ichiken-youtube/312_FlybackUSBCharger/README.md

# FlybackUSBCharger
本リポジトリはイチケンが以下の動画で製作した自作フライバックコンバータ回路のリポジトリです。  
イチケン USB充電器を自作する。「勢いで作るフライバックコンバーター」編 (https://www.youtube.com/watch?v=C0eDFmK-wXY)
