ichiken-youtube/312_FlybackUSBCharger/FlybackConverter.kicad_pcb

## KiCad design FlybackConverter.kicad_pcb (2024-11-19)

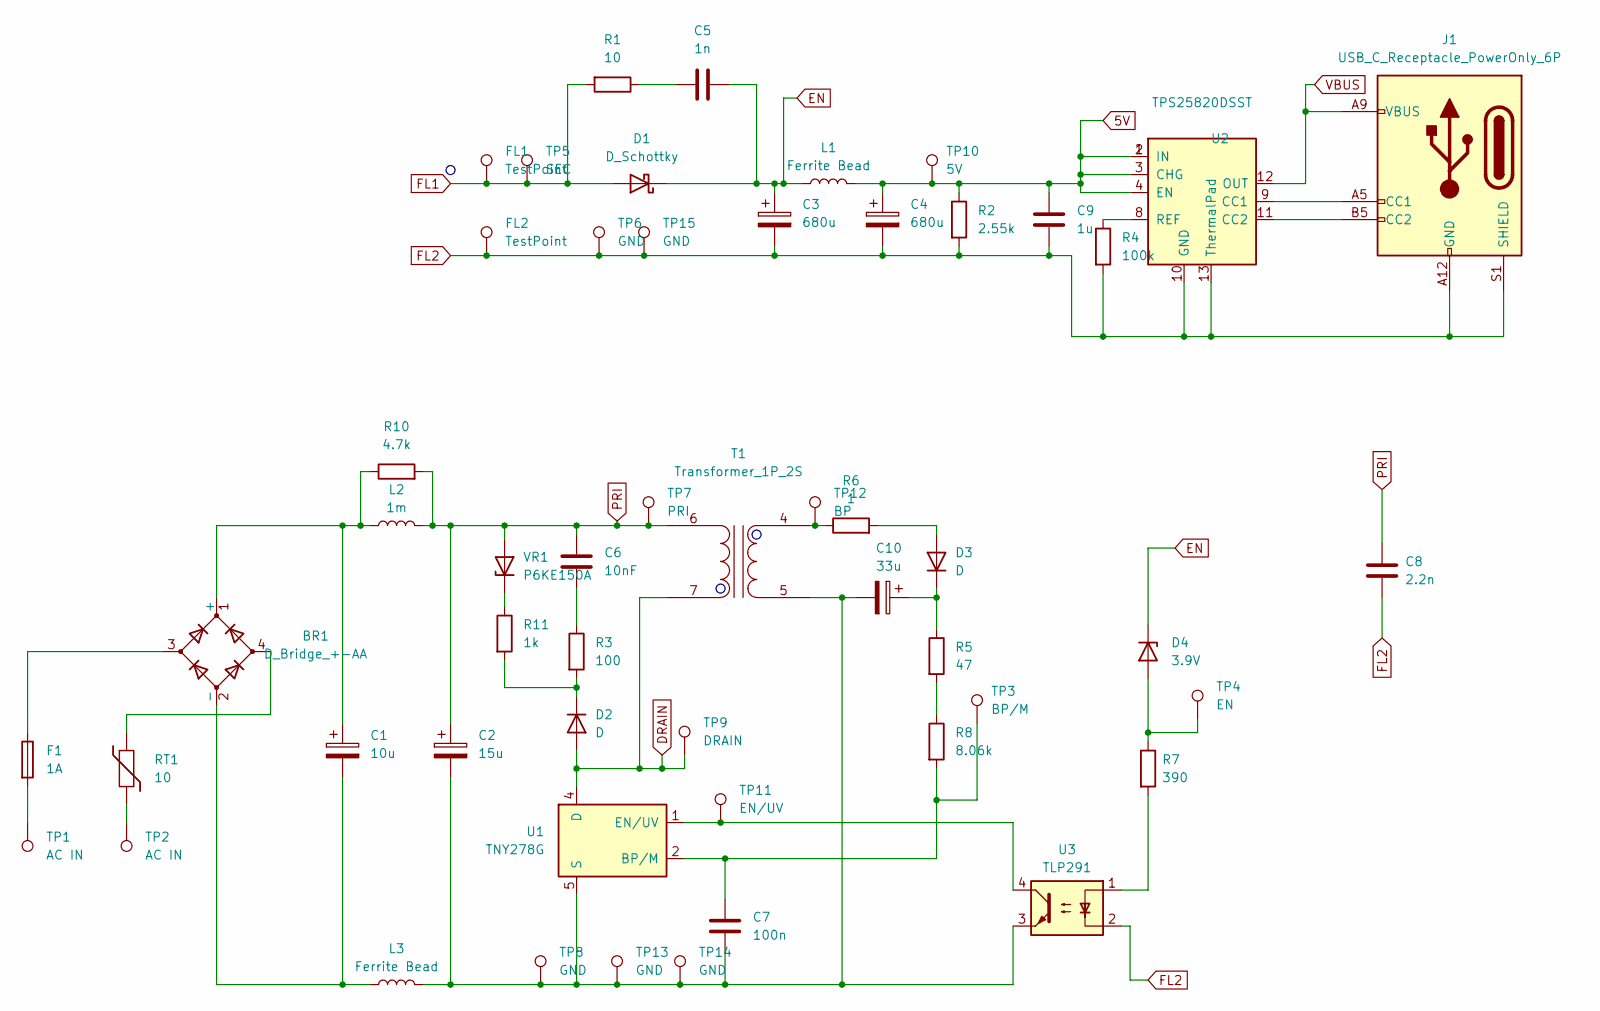
[picture p1: schematic FlybackConverter.kicad_sch]

Parts:
BR1: D_Bridge_+-AA; TO-269AA
C1: 10u; CP_Radial_D10.0mm_P5.00mm
C2: 15u; CP_Radial_D12.5mm_P5.00mm
C3, C4: 680u; CP_Radial_D8.0mm_P3.50mm
C5: 1n; C_0805_2012Metric
C6: 10nF; C_0805_2012Metric
C7: 100n; C_1206_3216Metric
C8: 2.2n; C_Disc_D10.5mm_W5.0mm_P10.00mm
C9: 1u; C_0805_2012Metric
C10: 33u; CP_Radial_D5.0mm_P2.50mm
D1: D_Schottky; D_PowerDI-5
D2: D; D_SMA
D3: D; D_SMF
D4: 3.9V; D_SOD-323
F1: 1A; C_Rect_L7.2mm_W4.5mm_P5.00mm_FKS2_FKP2_MKS2_MKP2
FL1, FL2: TestPoint; TestPoint_Loop_D1.80mm_Drill1.0mm_Beaded
J1: USB_C_Receptacle_PowerOnly_6P; USB-C-SMD_TYPE-C-6P
L1, L3: Ferrite Bead; R_Axial_DIN0309_L9.0mm_D3.2mm_P12.70mm_Horizontal
L2: 1m; L_Radial_D9.5mm_P5.00mm_Fastron_07HVP
R1: 10; R_0805_2012Metric
R2: 2.55k; R_0805_2012Metric
R3: 100; R_1206_3216Metric
R4: 100k; R_0603_1608Metric
R5: 47; R_0603_1608Metric
R6: 1; R_0603_1608Metric
R7: 390; R_0603_1608Metric
R8: 8.06k; R_0603_1608Metric
R10: 4.7k; R_0603_1608Metric
R11: 1k; R_1206_3216Metric
RT1: 10; C_Disc_D10.5mm_W5.0mm_P7.50mm
T1: Transformer_1P_2S; B66206W1110T001
TP1, TP2: AC IN; TestPoint_Loop_D1.80mm_Drill1.0mm_Beaded
TP3: BP/M; TestPoint_Loop_D1.80mm_Drill1.0mm_Beaded
TP4: EN; TestPoint_Loop_D1.80mm_Drill1.0mm_Beaded
TP5: SEC; TestPoint_Loop_D1.80mm_Drill1.0mm_Beaded
TP6, TP8, TP13, TP14, TP15: GND; TestPoint_Loop_D1.80mm_Drill1.0mm_Beaded
TP7: PRI; TestPoint_Loop_D1.80mm_Drill1.0mm_Beaded
TP9: DRAIN; TestPoint_Loop_D1.80mm_Drill1.0mm_Beaded
TP10: 5V; TestPoint_Loop_D1.80mm_Drill1.0mm_Beaded
TP11: EN/UV; TestPoint_Loop_D1.80mm_Drill1.0mm_Beaded
TP12: BP; TestPoint_Loop_D1.80mm_Drill1.0mm_Beaded
U1: TNY278G; PowerIntegrations_SMD-8C
U2: TPS25820DSST; TPS25820
U3: TLP291; SOIC-4_4.55x2.6mm_P1.27mm
VR1: P6KE150A; D_DO-15_P10.16mm_Horizontal

Connections:
5V: C4.1, C9.1, L1.2, R2.1, TP10.1, U2.1 (IN), U2.2 (IN), U2.3 (CHG), U2.4 (EN)
DRAIN: D2.2 (A), T1.7 (AB), TP9.1, U1.4 (D)
EN: C3.1, C5.2, D1.1 (K), D4.1 (K), L1.1
FL1: D1.2 (A), FL1.1, R1.2, TP5.1
FL2: C3.2, C4.2, C8.2, C9.2, FL2.1, J1.A12 (GND), J1.B12 (GND), J1.S1 (SHIELD), R2.2, R4.2, TP6.1, TP15.1, U2.10 (GND), U2.13 (ThermalPad), U3.2
unnamed: BR1.1 (+), C1.1, L2.1, R10.1
unnamed: BR1.2 (-), C1.2, L3.1
unnamed: BR1.3, F1.1
unnamed: BR1.4, RT1.1
unnamed: C5.1, R1.1
unnamed: C6.2, R3.1
unnamed: D2.1 (K), R3.2, R11.2
unnamed: D3.2 (A), R6.2
unnamed: C10.1, D3.1 (K), R5.1
unnamed: D4.2 (A), R7.1, TP4.1
unnamed: F1.2, TP1.1
unnamed: J1.A5 (CC1), U2.9 (CC1)
unnamed: J1.B5 (CC2), U2.11 (CC2)
unnamed: R5.2, R8.1
unnamed: R7.2, U3.1
unnamed: RT1.2, TP2.1
unnamed: C2.2, C7.2, C10.2, L3.2, T1.5 (SA), TP8.1, TP13.1, TP14.1, U1.5 (S), U1.6 (S), U1.7 (S), U1.8 (S), U3.3
unnamed: R6.1, T1.4 (SB), TP12.1
unnamed: C7.1, R8.2, TP3.1, U1.2 (BP/M)
unnamed: TP11.1, U1.1 (EN/UV), U3.4
unnamed: R4.1, U2.8 (REF)
unnamed: R11.1, VR1.1 (K)
PRI: C2.1, C6.1, C8.1, L2.2, R10.2, T1.6 (AA), TP7.1, VR1.2 (A)
VBUS: J1.A9 (VBUS), J1.B9 (VBUS), U2.12 (OUT)

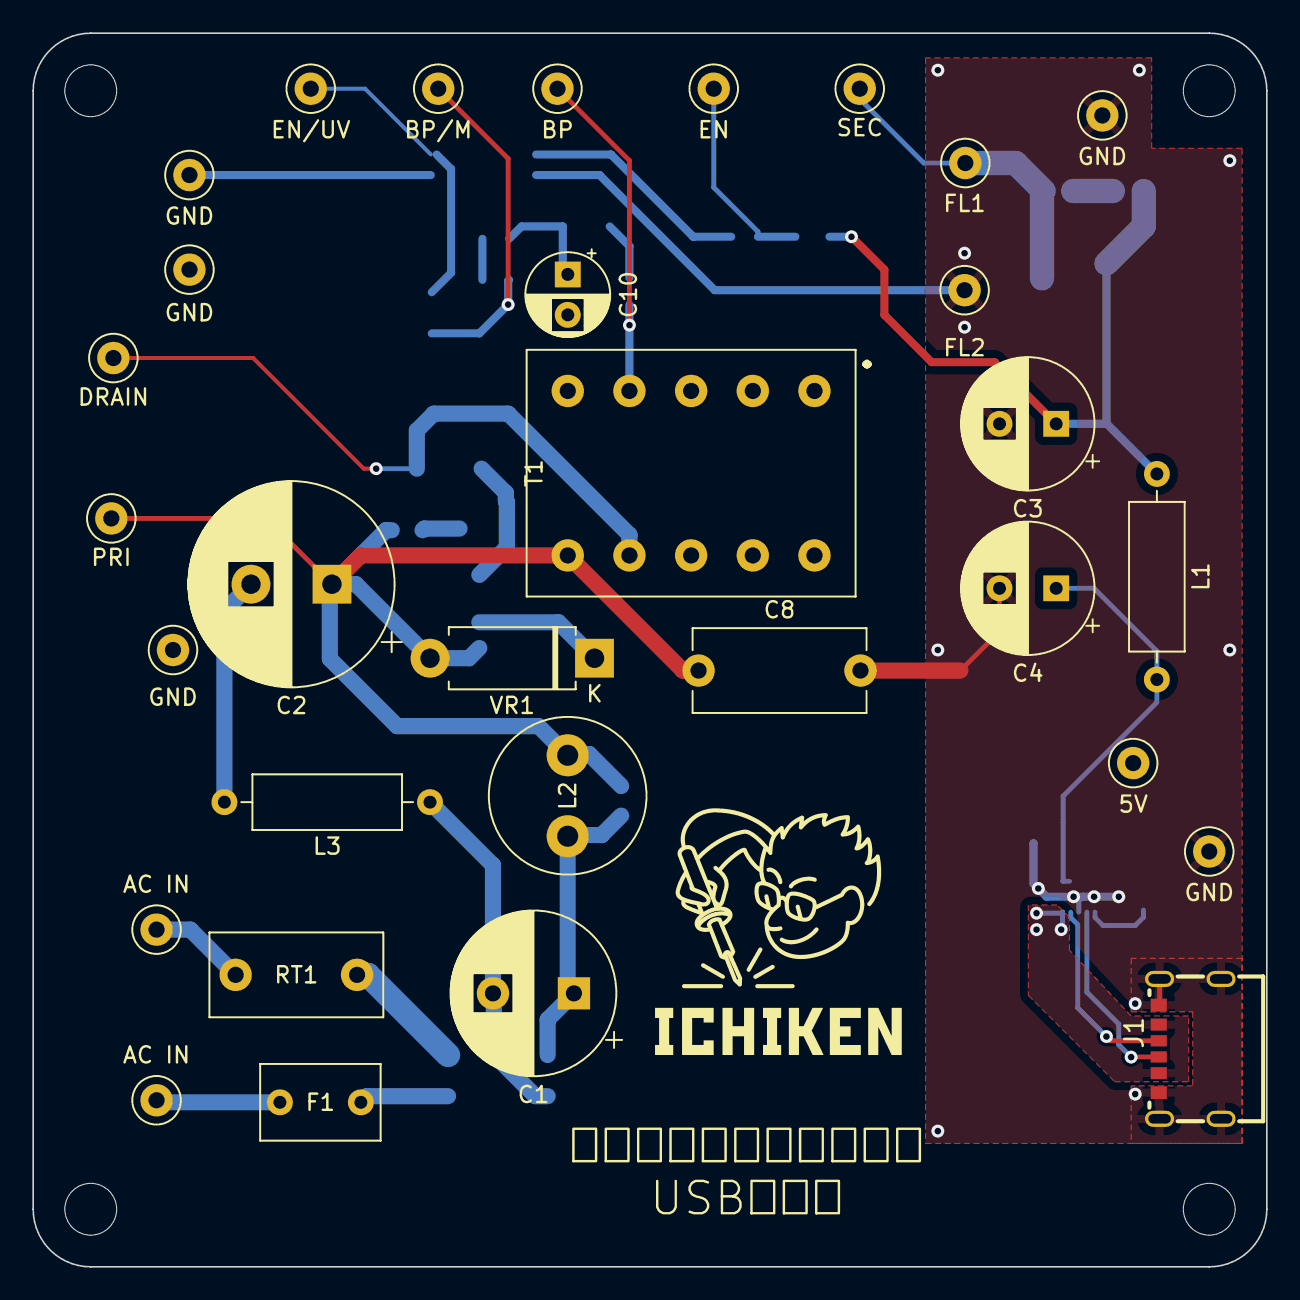
[picture p2: board FlybackConverter.kicad_pcb from above]

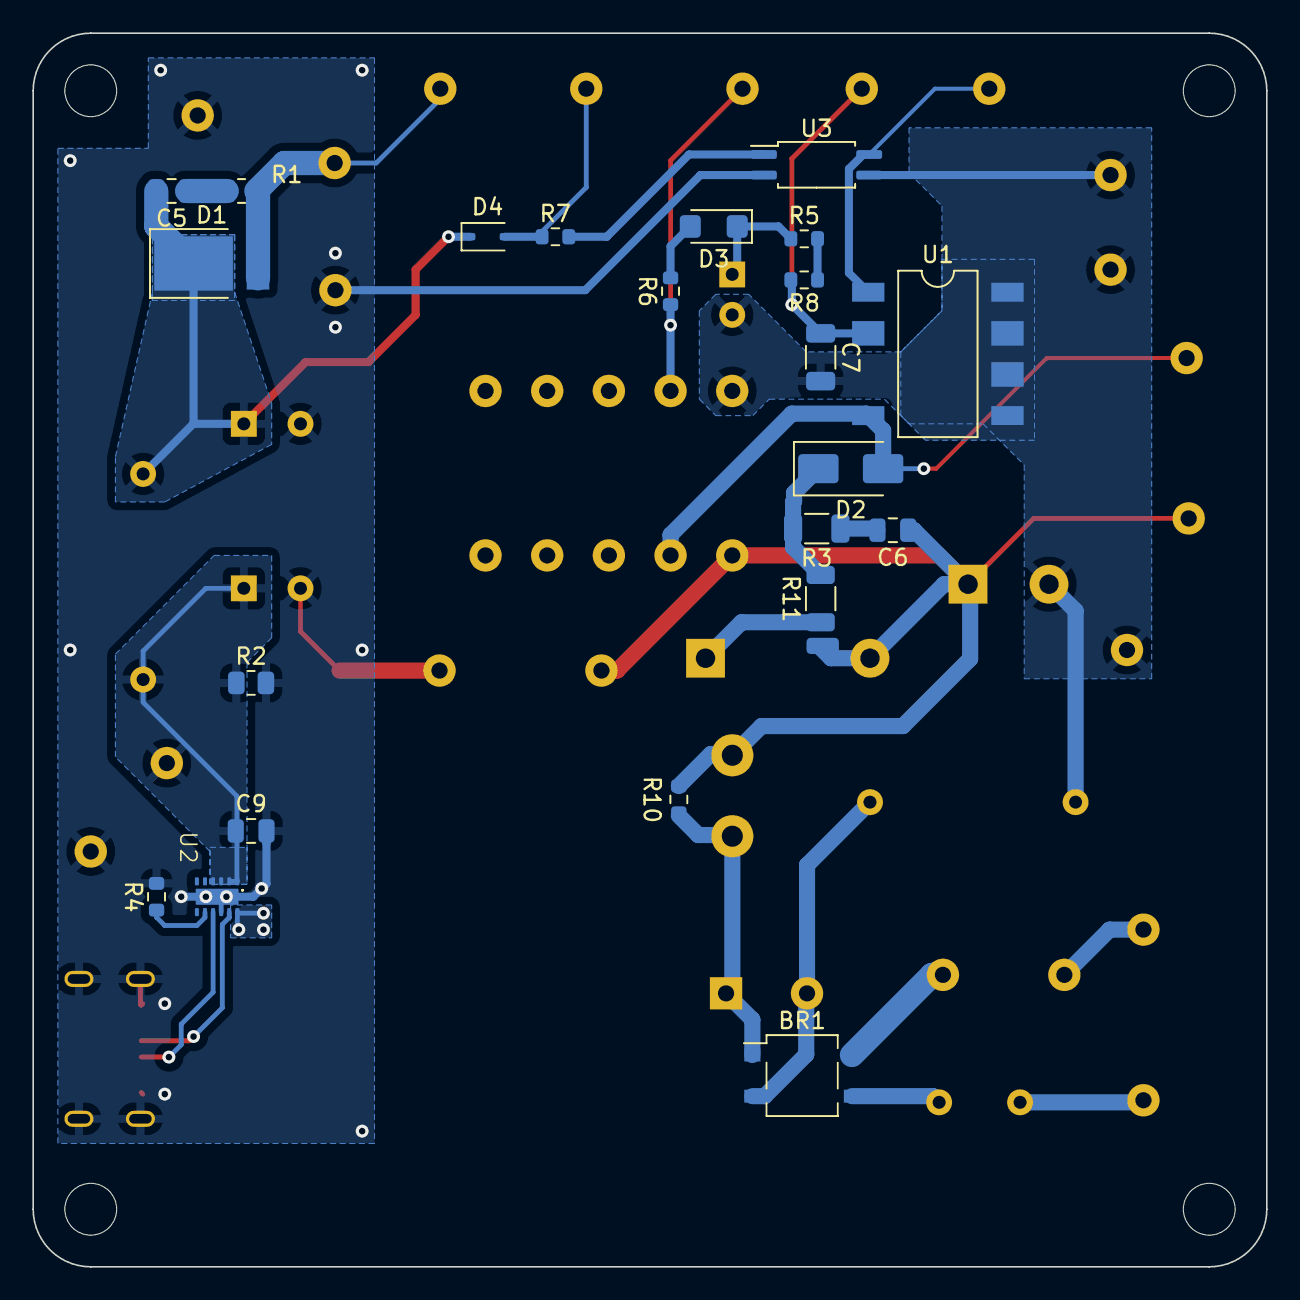
[picture p3: board FlybackConverter.kicad_pcb from below]

Board: 2 copper layers, 76.2 x 76.2 mm, 53 parts (22 on the bottom side), 29 nets.
