ichiken-youtube/312_FlybackUSBCharger/(commit log)

2024-10-09 スイッチングICをLNK6428Kに変更
    [FlybackConverter.kicad_sch]
2024-10-09 フットプリント追加
    [FlybackConverter.kicad_sch]
2024-10-10 フットプリント設定
    [FlybackConverter.kicad_sch]
2024-10-10 トランスのフットプリント修正、FL1,2に合わせてシンボル変更
    [FlybackConverter.kicad_pcb, FlybackConverter.kicad_sch]
2024-10-10 TypeC仮配置 #1
    [FlybackConverter.kicad_pcb, FlybackConverter.kicad_sch]
2024-10-11 USBコントローラ配置 #1
    [FlybackConverter.kicad_pcb, FlybackConverter.kicad_sch]
2024-10-11 AC側配線幅1mmで統一 fix #4
    [FlybackConverter.kicad_pcb]
2024-10-11 パスコン設置 fix #1
    [FlybackConverter.kicad_pcb, FlybackConverter.kicad_sch]
2024-10-11 可変抵抗接続用に配線を引き出せる穴を追加 fix #2
    [FlybackConverter.kicad_pcb, FlybackConverter.kicad_sch]
2024-10-11 トランスのフットプリントを10pinに修正
    [FlybackConverter.kicad_pcb, FlybackConverter.kicad_sch]
2024-10-11 TP追加 fix #3
    [FlybackConverter.kicad_pcb]
2024-10-11 U1のサーマルパッドのリリーフなし
    [FlybackConverter.kicad_pcb]
2024-10-15 C7のフットプリントを1206に変更 #5
    [FlybackConverter.kicad_pcb, FlybackConverter.kicad_sch]
2024-10-16 B66206W1110T001フットプリント作成 #6
2024-10-16 トランスのフットプリント修正、それに合わせて部品配置も調整 fix #6
    [FlybackConverter.kicad_pcb, FlybackConverter.kicad_sch]
2024-10-18 Net-(T1-AA)の塗りつぶし無し、配線に置き換え #8
    [FlybackConverter.kicad_pcb]
2024-10-18 配線位置微修正、DRC問題無し #8
    [FlybackConverter.kicad_pcb]
2024-10-18 出力をTypeCに変更したのに合わせてreadme修正
2024-10-18 スナバ配置変更 fix #8
    [FlybackConverter.kicad_pcb]
2024-10-31 トランス周辺のネット名変更
    [FlybackConverter.kicad_pcb, FlybackConverter.kicad_sch]
2024-11-15 コイル極性メモ
    [FlybackConverter.kicad_sch]
2024-11-18 回路修正
    [FlybackConverter.kicad_sch]
2024-11-18 TP以外大体配置できた #10
    [FlybackConverter.kicad_pcb, FlybackConverter.kicad_sch]
2024-11-19 TP配置
    [FlybackConverter.kicad_pcb, FlybackConverter.kicad_sch]
2024-11-19 VR1バイパス用パッドのネット変更
    [FlybackConverter.kicad_pcb]
2024-12-02 回路図を現物に合わせて修正 #12
    [FlybackConverter.kicad_sch]
2024-12-02 readme途中
2024-12-02 readme途中 #12
2024-12-02 アウトラインのみ作った
2024-12-03 トランス組み立て手順
2024-12-03 動作確認手順を記述
2024-12-03 動作確認手順など fix #12
2024-12-03 改行位置など修正 #12
2024-12-03 細かいパラメータ修正
    [FlybackConverter.kicad_sch]
2024-12-04 画像にUEWの径を追記
2024-12-06 R7(FBツェナー部分)抵抗値修正 #12
    [FlybackConverter.kicad_sch]
2025-08-18 readme 組み立て手順削除
2025-08-18 埋め込み動画コメントアウト
2025-08-18 readme用画像削除
2025-08-19 動画埋め込み
